Arkzeil/ESP32-smart-streetlight/(commit log)

2023-10-27 add ESP32 code
2023-12-13 To collect voltage info
